zarattee/ROBOT_UVE/doc/lista de componentes.xls

Lista de materiales
Proyecto: |  | ROBOT UVE
Curso:
Fecha:
Autor: |  | ZARATE ELIAS
Moneda: |  | $ (Pesos) | Tipo de cambio: -
 | Designator | Footprint | CANT. | Value | Unit Price | Subtotal | Proveedor
1 | D4,D5 | DO-41 | 2 | 1N4148 | 33.000 | 66.00 | https://articulo.mercadolibre.com.ar/MLA-762837543-pack-5-diodo-senal-1n4148-200ma-100v-arduino-nubbeo-_JM | viene un pack de 5unidades
2 | J7,J10,J8,J9,J11,J12 | PIN_STRIP4 | 6 | HC-SR04 |  | 0.00
3 | P15,P18,P14,P17 | Header_2x05x2.54mm_Vertical | 4 | MOTOR1,2,3,4 |  | 0.00
4 | P16 | Header_2x05x2.54mm_Vertical | 1 | SENSORES_DE_LINEA |  | 0.00
5 | J4 | PIN_STRIP4 | 1 | COMUNICACION DE LA RPI |  | 0.00
6 | J1 | Pin_Header_2 | 1 | PULSADOR1 |  | 0.00
7 | C2,C1,C3 | CAP_ELEC_5x11mm | 3 | 10uF |  | 0.00
8 | J3,J13 | BORNERA3_AZUL | 2 | NC - C – NA | 73.000 | 146.00 | https://articulo.mercadolibre.com.ar/MLA-720073053-bornera-3x1-8a-terminal-conector-tornillo-polos-pines-pcb-_JM
9 | P1 | Socket_Strip_Arduino_2x18 | 1 | Digital |  | 0.00
10 | P2 | Socket_Strip_Arduino_1x08 | 1 | Power |  | 0.00
11 | P3,P4 | Socket_Strip_Arduino_1x08 | 2 | Analog |  | 0.00
12 | P5 | Socket_Strip_Arduino_1x10 | 1 | PWM
13 | P6 | Socket_Strip_Arduino_1x08 | 1 | PWM
14 | P7 | Socket_Strip_Arduino_1x08 | 1 | Communication
15 | P8,P9,P10,P11,P12,P13 | Arduino_1pin | 6 | CONN_01X01
16 | BZ1 | Buzzer_12mm | 1 | Buzzer | 89.000 | 89.00 | https://articulo.mercadolibre.com.ar/MLA-884391749-mini-zumbador-pasivo-2khz-33v-5v-dc-12mm-buzzer-_JM
17 | H1,H2,H3,H4 | hole_3mm | 4 | Mounting_Hole
18 | J15,J17,J16,J14,J2,J21,J4 | PIN_STRIP4 | 6 | NEOPIXEL,I2C,IR |  | 0.00
19 | J5,J6,J19 | BORNERA2_AZUL | 10 | BORNERAS | 13.600 | 136.00 | https://articulo.mercadolibre.com.ar/MLA-761240759-kit-x10-unid-bornera-p-pcb-serie-301-azul-2-bornes-_JM | es mas economico comprar x10 que por x3 | se usaran 3
20 | K1,K3 | RELAY_C | 2 | RELAY_C | 139.000 | 278.00 | https://articulo.mercadolibre.com.ar/MLA-876582598-relay-rele-inversor-24v-de-10a-250v-5-pin-srd-24vdc-sl-c-_JM
21 | D2 | sod123 | 1 | 1N4148 |  | 0.00
22 | Q1,Q3,Q4 | SOT23 | 3 | 2N7002 |  | 0.00
23 | SW1 | Pulsador_TH_4 | 1 | RESET | 25.000 | 25.00 | https://articulo.mercadolibre.com.ar/MLA-665394614-pulsador-dip-tact-switch-6x6x5mm-arduino-avr-pic-mona-_JM
24 | R1,R3,R6,R2,R4,R5 | R_1206 | 6 | 10K |  | 0.00
25 |  |  |  |  |  | 0.00
 |  | Notas |  |  | TOTAL | 740.00
