zarattee/ROBOT_UVE/doc/robot uve.pdf

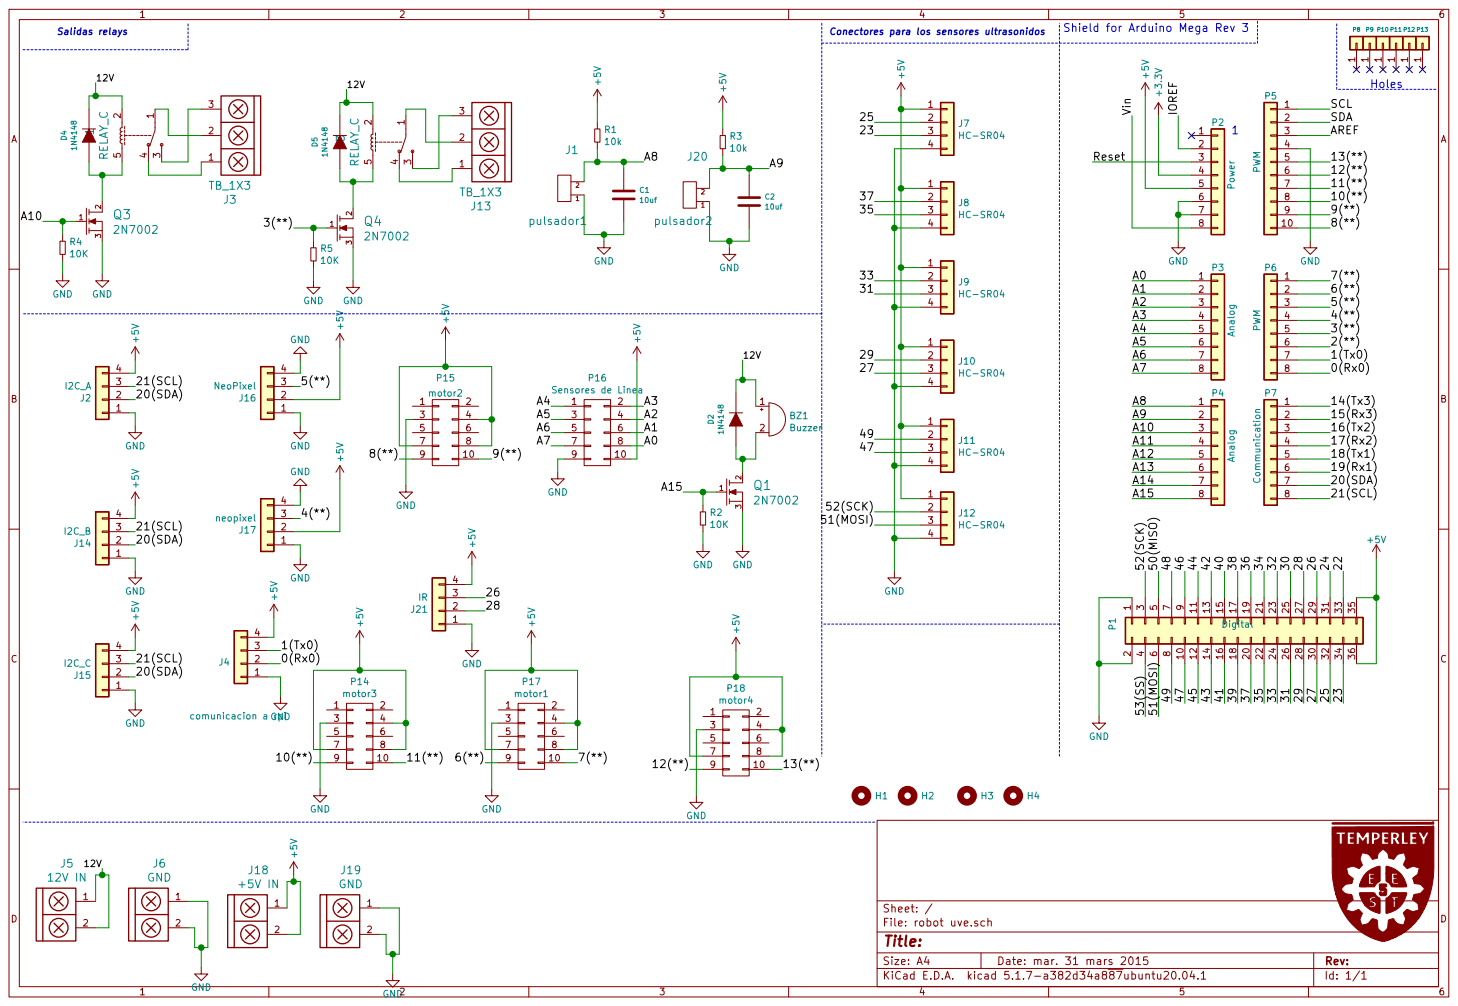
[picture p1: page 1]

Id: 1/1 Title: File: robot uve.sch Sheet: /
