zarattee/ROBOT_UVE/robot uve.kicad_pcb

## KiCad design robot uve.kicad_pcb (2020-12-02)

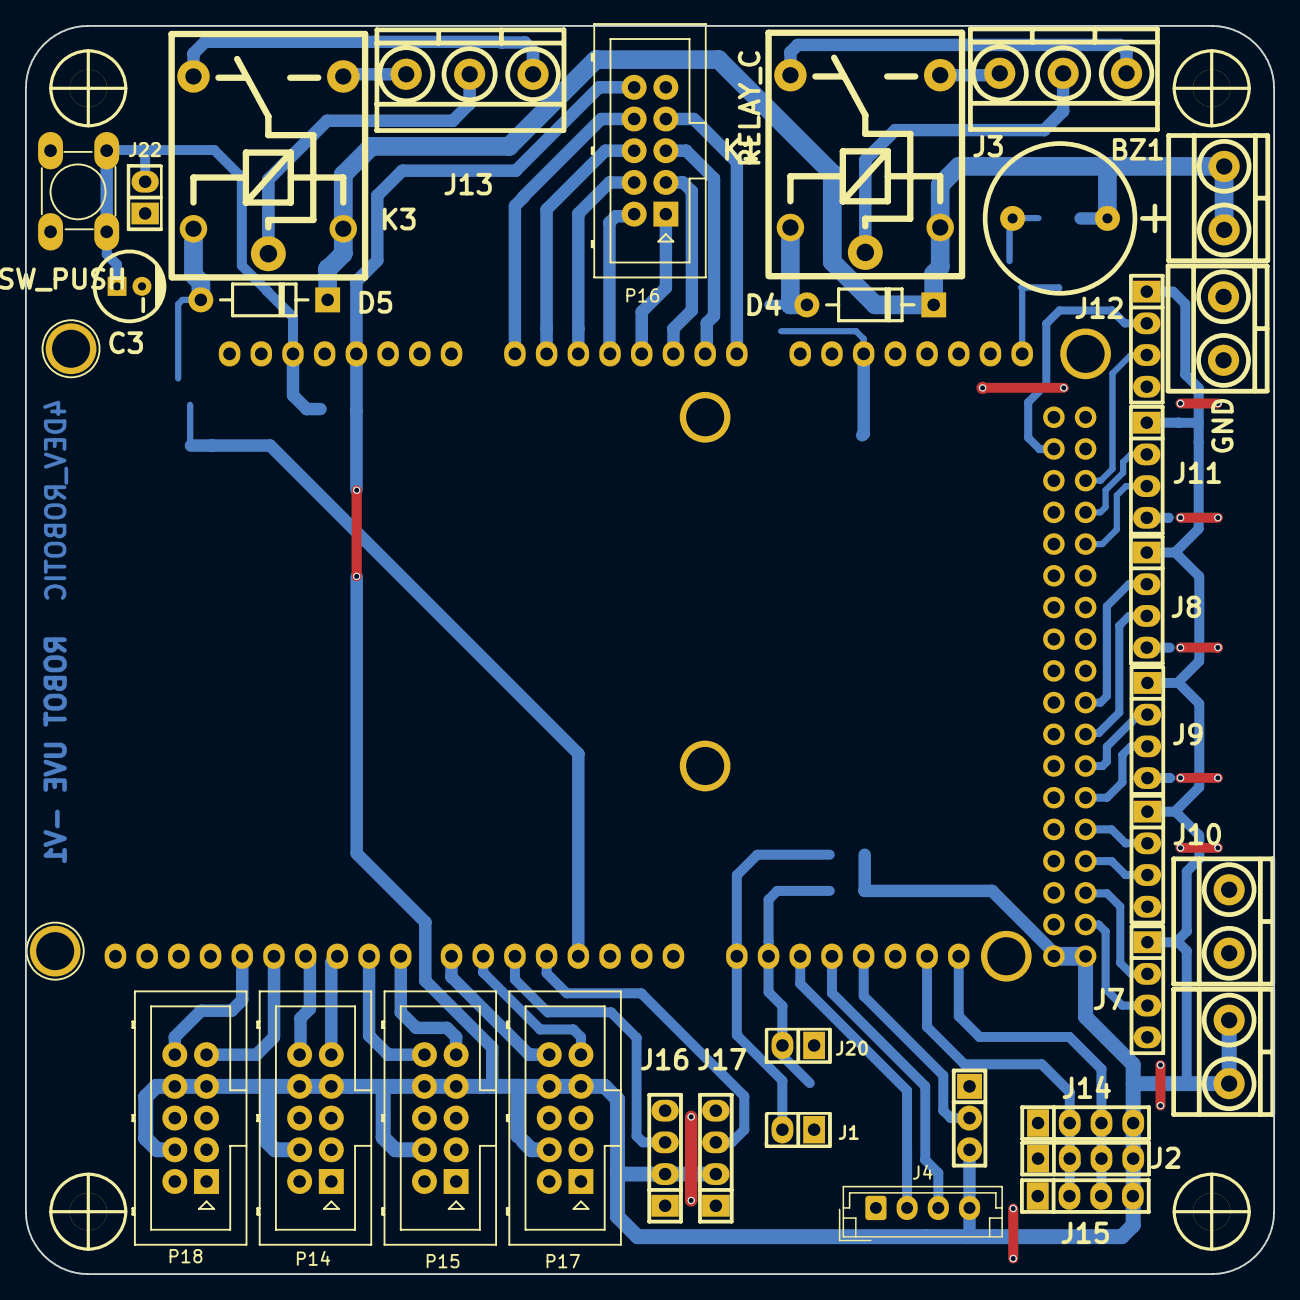
[picture p2: board robot uve.kicad_pcb from above]

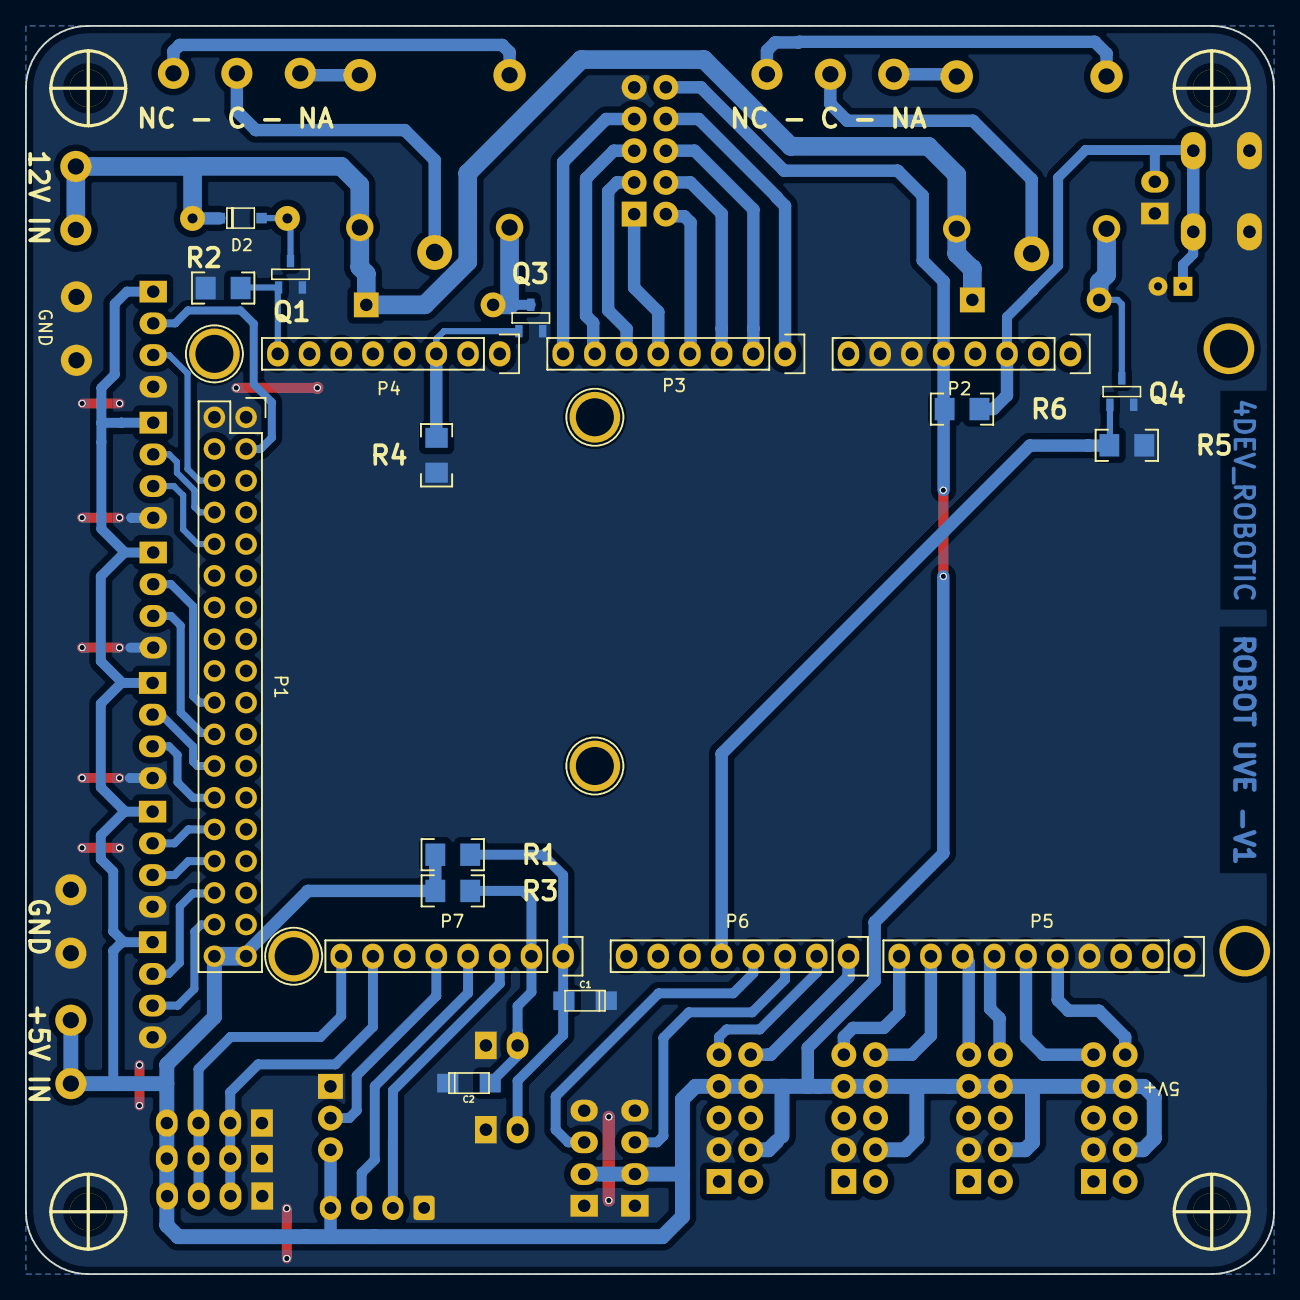
[picture p3: board robot uve.kicad_pcb from below]

Board: 2 copper layers, 100.0 x 100.0 mm, 63 parts (23 on the bottom side), 53 nets.

Parts:
BZ1: Buzzer; Buzzer_12mm
C1, C2: 10uf; CAP_TAN_A
C3: 10uf; CAP_ELEC_5x11mm
D2: 1N4148; sod123
D4, D5: 1N4148; DO-41
H1, H2, H3, H4: Mounting_Hole; hole_3mm
J1: pulsador1; Pin_Header_2
J2: I2C_A; pin_strip_4
J3, J13: NC - C - NA; BORNERA3_AZUL
J4: comunicacion a rpi; JST_EH_B4B-EH-A_1x04_P2.50mm_Vertical
J5: 12V IN; BORNERA2_AZUL
J6, J19: GND; BORNERA2_AZUL
J7, J8, J9, J10, J11, J12: HC-SR04; pin_strip_4
J14: I2C_B; pin_strip_4
J15: I2C_C; pin_strip_4
J16: NeoPixel; pin_strip_4
J17: neopixel; pin_strip_4
J18: +5V IN; BORNERA2_AZUL
J20: pulsador2; Pin_Header_2
J21: IR; Pin_Strip_3
J22: RST; Pin_Header_2
K1, K3: RELAY_C; Relay_C
P1: Digital; Socket_Strip_Arduino_2x18
P2: Power; Socket_Strip_Arduino_1x08
P3, P4: Analog; Socket_Strip_Arduino_1x08
P5: PWM; Socket_Strip_Arduino_1x10
P6: PWM; Socket_Strip_Arduino_1x08
P7: Communication; Socket_Strip_Arduino_1x08
P8, P9, P10, P11, P12, P13: CONN_01X01; Arduino_1pin
P14: motor3; Header_2x05x2.54mm_Vertical
P15: motor2; Header_2x05x2.54mm_Vertical
P16: Sensores de Linea; Header_2x05x2.54mm_Vertical
P17: motor1; Header_2x05x2.54mm_Vertical
P18: motor4; Header_2x05x2.54mm_Vertical
Q1, Q3, Q4: 2N7002; SOT23
R1, R3, R6: 10k; R_1206
R2, R4, R5: 10K; R_1206
SW1: SW_PUSH; Pulsador_TH_4

Connections:
+5V: J2.4, J4.4, J7.1, J8.1, J9.1, J10.1, J11.1, J12.1, J14.4, J15.4, J16.2, J17.2, J18.1, J18.2, J21.3, P1.35, P1.36, P2.5, P14.4, P14.7, P14.8, P15.4, P15.7, P15.8, P16.10, P17.4, P17.7, P17.8, P18.4, P18.7, P18.8, R1.1, R3.1, R6.1
/3(**): P6.5, Q4.1, R5.1
/4(**): J17.3, P6.4
/5(**): J16.3, P6.3
/6(**): P6.2, P17.9
/7(**): P6.1, P17.10
/8(**): P5.10, P15.9
/9(**): P5.9, P15.10
/10(**): P5.8, P14.9
/11(**): P5.7, P14.10
/12(**): P5.6, P18.9
/12V: BZ1.1, D2.2, D4.2, D5.2, J5.1, J5.2, K1.2, K3.2
/13(**): P5.5, P18.10
/14(Tx3): C1.1, J1.2, P7.1, R1.2
/15(Rx3): C2.1, J20.2, P7.2, R3.2
/16(Tx2): J4.2, P7.3
/17(Rx2): J4.3, P7.4
/18(Tx1): J21.2, P7.5
/20(SDA): J2.2, J14.2, J15.2, P7.7
/21(SCL): J2.3, J14.3, J15.3, P7.8
/23: J7.3, P1.34
/25: J7.2, P1.32
/27: J10.3, P1.30
/29: J10.2, P1.28
/31: J9.3, P1.26
/33: J9.2, P1.24
/35: J8.3, P1.22
/37: J8.2, P1.20
/47: J11.3, P1.10
/49: J11.2, P1.8
/51(MOSI): J12.3, P1.6
/52(SCK): J12.2, P1.3
/A0: P3.1, P16.8
/A1: P3.2, P16.6
/A2: P3.3, P16.4
/A3: P3.4, P16.2
/A4: P3.5, P16.1
/A5: P3.6, P16.3
/A6: P3.7, P16.5
/A7: P3.8, P16.7
/A10: P4.3, Q3.1, R4.1
/A15: P4.8, Q1.1, R2.1
/Reset: C3.1, J22.2, P2.3, R6.2, SW1.3, SW1.4
GND: C1.2, C2.2, C3.2, J1.1, J2.1, J4.1, J6.1, J6.2, J7.4, J8.4, J9.4, J10.4, J11.4, J12.4, J14.1, J15.1, J16.1, J16.4, J17.1, J17.4, J19.1, J19.2, J20.1, J21.1, J22.1, P1.1, P1.2, P2.6, P2.7, P5.4, P14.3, P15.3, P16.9, P17.3, P18.3, Q1.3, Q3.3, Q4.3, R2.2, R4.2, R5.2, SW1.1, SW1.2
unnamed: BZ1.2, D2.1, Q1.2
unnamed: D4.1, K1.5, Q3.2
unnamed: D5.1, K3.5, Q4.2
unnamed: J3.1, K1.4
unnamed: J3.2, K1.1
unnamed: J3.3, K1.3
unnamed: J13.1, K3.4
unnamed: J13.2, K3.1
unnamed: J13.3, K3.3
