zarattee/ROBOT_UVE/(commit log)

2020-11-27 SE AGREGA ARCHIVOS DE FABRICACION
    se acomo los archivos a sus carpetas y se agrego los archicos de fabricacion
    [robot uve-Bottom_Mask.gbr, robot uve-Bottom_layer.gbr, robot uve-Bottom_silkscreen.gbr, robot uve-border.gbr, robot uve-drill.drl, robot uve-top_Mask.gbr, robot uve-top_layer.gbr, robot uve-top_silkscreen.gbr]
2020-11-27 Actualización modelo 3D
    Ajuste el modelo 3D de los conectores de cable plano 2x5 para los drivers de motores
    [robot uve.kicad_pcb, robot uve.sch]
2020-11-27 se modifico archicos de fabricacion
    se modifico archivos de fabricaciony se mejoro el pcb
    [robot uve-Bottom_Mask.gbr, robot uve-Bottom_layer.gbr, robot uve-Bottom_silkscreen.gbr, robot uve-border.gbr, robot uve-drill.drl, robot uve-top_Mask.gbr, robot uve-top_layer.gbr, robot uve-top_silkscreen.gbr]
2020-11-30 modificacion en el pcb
    se modifico el pcb
    se agrego boton reset
    se modifico seregrafia
    se modifico vias
    y se agrego archicos BOM
    [robot uve.kicad_pcb, robot uve.sch]
2020-11-30 Varios
    Pase a SMD (1206) las resistencias.
    Modifique una conexión a 5V para evitar un jumper.
    Acomode un poco más la serigrafia (todavía falta).
    [robot uve.kicad_pcb, robot uve.sch]
2020-12-01 varios cambios
    se agrega lista de componentes
    se modifica el pcb
    [lista de componentes.xls, robot uve.kicad_pcb]
2020-12-01 LISTA DE COMPONENTES
    SE MODIFICO LISTA DE COMPONENTES
    [lista de componentes.xls]
2020-12-01 Img Pinout + avances en pcb
    Agregue la imagen del pinout del arduino Mega en el sch, esta en una escala muy baja para que no moleste, en caso de necesitar revisar algo, cambiar la escala y luego volverla a la actual.
    Cambie el icono del rotulo de SCH.
    Movi un SOT-23 para que el poligono de GND pueda pasar por debajo del relay y evitar un jumper.
    [robot uve.kicad_pcb]
2020-12-01 MODIFICACIONES
    se modifico pcb
    se movio los conectores para eviar 2 vias mas
    se cambio de huella pin_strip_4 a JST_4
    al conectior de comunicacion a rpi
    se esta armando la lista de componentes
    se modifico el SCH para que reorganizar el ruteo del pcb
    [lista de componentes.xls, robot uve.kicad_pcb]
2020-12-02 Reasignación de pines y layout
    Cambié la conexion del control IR, de la comunicacion serie hacia la RPI.
    Cambié el footprint de los capacitores de los pulsadores y redibuje el pcb para contemplar los cambios
    [robot uve.kicad_pcb]
2020-12-02 VCC width
    Cambié el ancho de la pista de alimentación
    [robot uve.kicad_pcb]
2020-12-02 Alineación de vias
    Acomode las vias de GND del lateral derecho y genere el archivo para la fabricacion casera.
    [robot uve.kicad_pcb]
2020-12-03 actualizacion de lista de componentes
    se agrago precios de algunos componentes en la lista de componetes
    [lista de componentes.xls]
